d4rkwyng/inspectron-sao-dc34/THIRD_PARTY_LICENSES.md

# Third-party code notices

## Adafruit_CircuitPython_ST7789

Redistributed in compiled form at `firmware/dist/lib/adafruit_st7789.mpy`
(and inside the released golden image).
https://github.com/adafruit/Adafruit_CircuitPython_ST7789

> MIT License
>
> Copyright (c) 2019 Melissa LeBlanc-Williams for Adafruit Industries
>
> Permission is hereby granted, free of charge, to any person obtaining a
> copy of this software and associated documentation files (the
> "Software"), to deal in the Software without restriction, including
> without limitation the rights to use, copy, modify, merge, publish,
> distribute, sublicense, and/or sell copies of the Software, and to
> permit persons to whom the Software is furnished to do so, subject to
> the following conditions:
>
> The above copyright notice and this permission notice shall be included
> in all copies or substantial portions of the Software.
>
> THE SOFTWARE IS PROVIDED "AS IS", WITHOUT WARRANTY OF ANY KIND, EXPRESS
> OR IMPLIED, INCLUDING BUT NOT LIMITED TO THE WARRANTIES OF
> MERCHANTABILITY, FITNESS FOR A PARTICULAR PURPOSE AND NONINFRINGEMENT.
> IN NO EVENT SHALL THE AUTHORS OR COPYRIGHT HOLDERS BE LIABLE FOR ANY
> CLAIM, DAMAGES OR OTHER LIABILITY, WHETHER IN AN ACTION OF CONTRACT,
> TORT OR OTHERWISE, ARISING FROM, OUT OF OR IN CONNECTION WITH THE
> SOFTWARE OR THE USE OR OTHER DEALINGS IN THE SOFTWARE.

## CircuitPython

The released golden image contains the CircuitPython 10.2.1 firmware
build. https://circuitpython.org

> MIT License
>
> Copyright (c) 2013-2026 Damien P. George and contributors;
> Copyright (c) Adafruit Industries and CircuitPython contributors
>
> (Same MIT permission and warranty text as above; full license at
> https://github.com/adafruit/circuitpython/blob/main/LICENSE)

## picotool

Referenced by the factory tooling, not redistributed. BSD-3-Clause,
© Raspberry Pi (Trading) Ltd.
https://github.com/raspberrypi/picotool
