d4rkwyng/inspectron-sao-dc34/sitegen/CHANNELS.md

# CHANNEL ROSTER — GENERATED by gen_secrets.py, do not hand-edit.
# Contains ALL ANSWERS. sitegen/ only — never deploy, never copy to
# the device. Regenerate: python3 sitegen/gen_secrets.py

## Visible dial (38 channels — TV/movies/commercials/music video only)

| CH | file | shown as | size |
|---|---|---|---|
| 2 | memes/stand_by.gif | STAND BY | 139KB |
| 3 | memes/wargames.gif | WARGAMES | 259KB |
| 4 | memes/matrix.gif | THE MATRIX | 319KB |
| 5 | memes/homerbush.gif | HOMER BUSH | 290KB |
| 6 | memes/apple1984.gif | MAC 1984 | 199KB |
| 7 | memes/colorbars.gif | COLOR BARS | 130KB |
| 8 | memes/ncis.gif | NCIS | 256KB |
| 10 | memes/readingrainbow.gif | RAINBOW | 194KB |
| 13 | memes/hacktheplanet.gif | HACK PLANET | 296KB |
| 15 | memes/nedry.gif | NEDRY | 186KB |
| 16 | memes/itcrowd_fire.gif | IT CROWD | 300KB |
| 17 | memes/printer.gif | PC LOAD LTR | 269KB |
| 19 | memes/eas.gif | EAS TEST | 53KB |
| 20 | memes/mtv.gif | MTV | 125KB |
| 21 | memes/beavis.gif | BEAVIS | 45KB |
| 22 | memes/fsociety.gif | FSOCIETY | 415KB |
| 25 | memes/alf.gif | ALF | 201KB |
| 26 | memes/smurfs.gif | SMURFS | 236KB |
| 27 | memes/scooby.gif | SCOOBY DOO | 154KB |
| 29 | memes/ducktales.gif | DUCKTALES | 217KB |
| 30 | memes/tmnt.gif | TURTLES | 137KB |
| 31 | memes/heman.gif | HE-MAN | 155KB |
| 32 | memes/transformers.gif | AUTOBOTS | 100KB |
| 33 | memes/dinosaurs.gif | DINOSAURS | 182KB |
| 34 | memes/defcon34.gif | DEF CON 34 | 67KB |
| 38 | memes/shamwow.gif | SHAMWOW | 174KB |
| 39 | memes/slimjim.gif | SLIM JIM | 194KB |
| 40 | memes/wheresthebeef.gif | WHERES BEEF | 174KB |
| 41 | memes/koolaid.gif | KOOL-AID | 227KB |
| 48 | memes/erasebutton.gif | RED BUTTON | 154KB |
| 49 | memes/grant.gif | DR GRANT | 243KB |
| 50 | memes/peterknee.gif | PETER KNEE | 234KB |
| 51 | memes/area51.gif | AREA 51 | 229KB |
| 52 | memes/dvd.gif | DVD LOGO | 382KB |
| 54 | memes/vegasstrip.gif | THE STRIP | 402KB |
| 56 | memes/riviera.gif | RIVIERA | 408KB |
| 57 | memes/fearloathing.gif | BAT COUNTRY | 281KB |
| 61 | memes/hackerman.gif | HACKERMAN | 211KB |

## Dead air (knock seats; prune when their reward unlocks)

CH 11, CH 23, CH 42, CH 66, CH 88

## Hidden — dial to unlock (18)

| dial | file | note | size |
|---|---|---|---|
| 011.0 | /secret/maxheadroom.gif | CF-05 Signal Intrusion | 141KB |
| 023.0 | /secret/testcardf.gif | CF-06 Test Card Lineage (knock) | 592KB |
| 034.1 | /secret/ident.gif | CF-00 Sign-On | 88KB |
| 053.0 | /secret/dns.gif | insider | 263KB |
| 066.0 | /secret/apollo.gif | CF-07 Tranquility Descent (knock) | 421KB |
| 080.0 | /secret/gadget.gif | CF-02 Know Your Set | 117KB |
| 088.0 | /secret/keyboardcat.gif | insider | 258KB |
| 089.0 | /secret/toasters.gif | insider | 271KB |
| 097.0 | /secret/clippy.gif | insider | 177KB |
| 098.0 | /secret/bsod.gif | insider | 106KB |
| 123.0 | /secret/elmothunder.gif | insider | 137KB |
| 170.4 | /secret/wopr.gif | CF-04 Only Winning Move | 10KB |
| 199.3 | /secret/defcon1.gif | CF-01 First Transmission | 523KB |
| 210.1 | /secret/allyourbase.gif | insider | 570KB |
| 222.0 | /secret/nyan.gif | insider | 81KB |
| 400.4 | /secret/silicon.gif | CF-03 Count the Frames | 297KB |
| 404.0 | /secret/meeseeks.gif | CF-09 Master Control (meta) | 260KB |
| 911.0 | /secret/this_is_fine.gif | insider | 173KB |

## Station knocks

- 003.0 -> 006.0 -> 023.0
- 063.0 -> 064.0 -> 066.0

## Other unlocks

- Konami (up up down down up down MODE) -> /secret/mooncake.gif (274KB)
- Badge I2C first contact -> /secret/badgelink.gif (19KB)

## Traps (play once, never persist)

| dial | file |
|---|---|
| 000.0 | /secret/rickroll.gif |
| 007.0 | /secret/rickroll.gif |
| 009.0 | /secret/movedon.gif |
| 013.3 | /secret/dickbutt.gif |
| 042.0 | /secret/dontpanic.gif |
| 067.0 | /secret/nogod67.gif |
| 069.0 | /secret/rickroll.gif |
| 088.8 | /secret/rickroll.gif |
| 123.4 | /secret/rickroll.gif |
| 133.7 | /secret/rickroll.gif |
| 187.0 | /secret/spyvsspy.gif |
| 345.0 | /secret/paperwork.gif |
| 420.0 | /secret/weed420.gif |
| 666.0 | /secret/rickroll.gif |
| 777.0 | /secret/jackpot777.gif |
