d4rkwyng/inspectron-sao-dc34/design/render-back.png

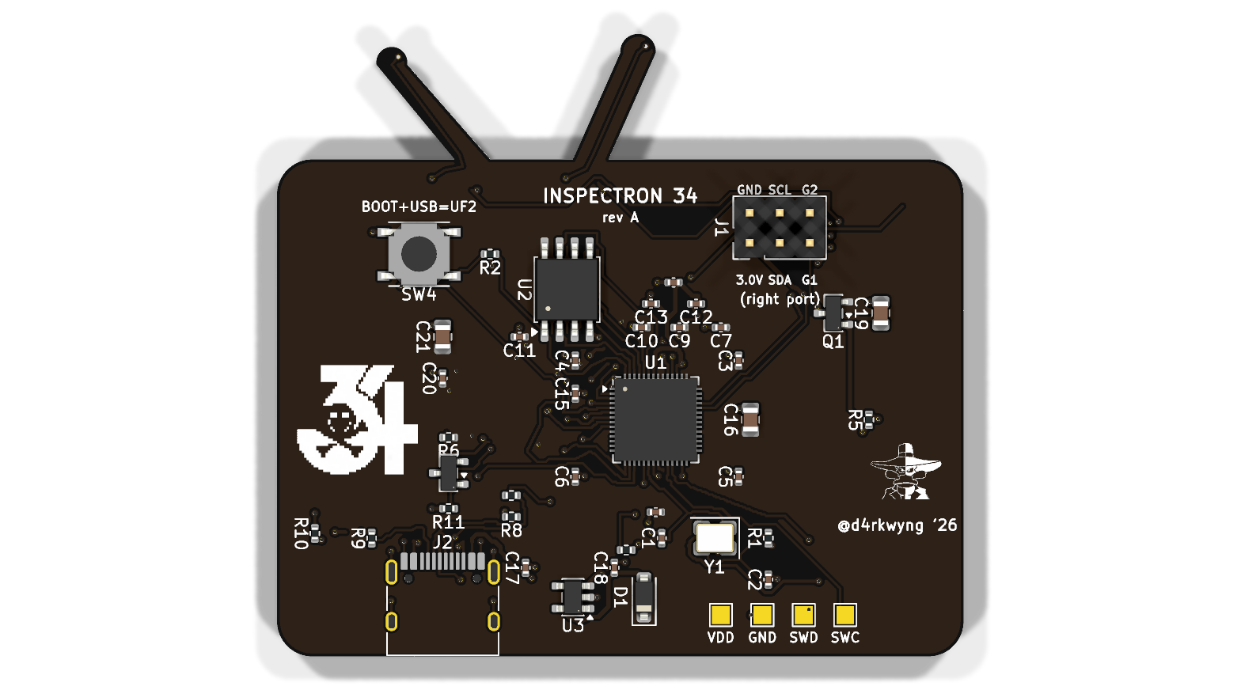
design/render-back.png
