d4rkwyng/inspectron-sao-dc34/design/render-front.png

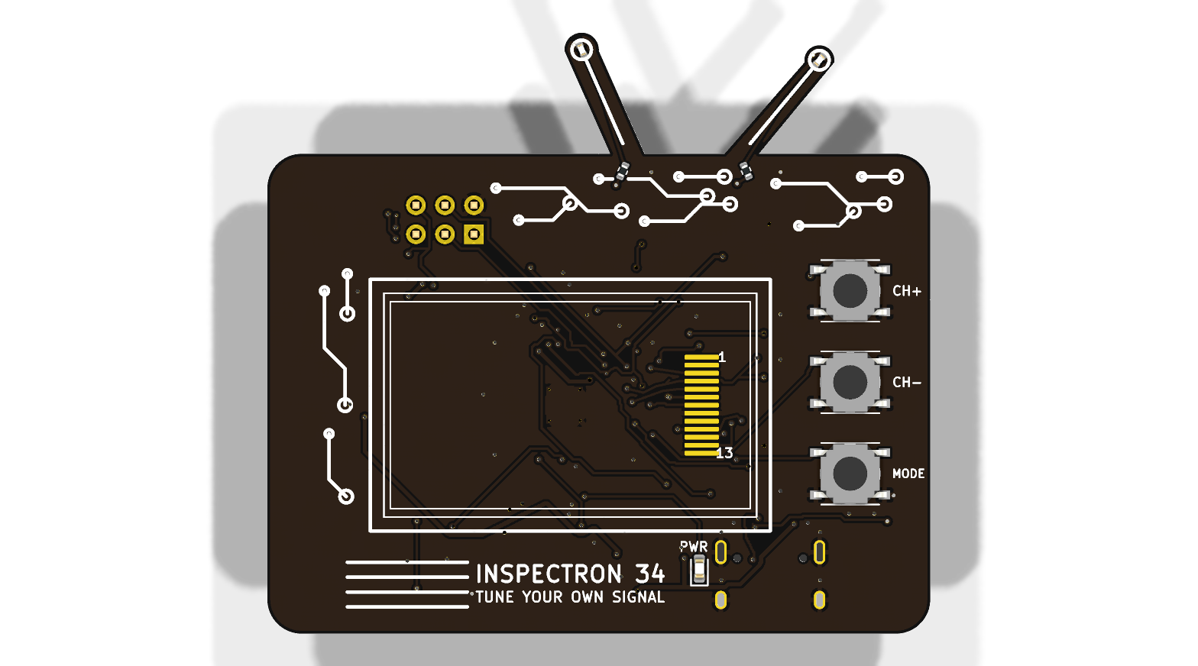
design/render-front.png
