d4rkwyng/inspectron-sao-dc34/firmware/memes/static.gif

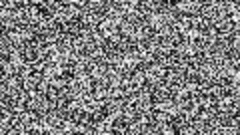
firmware/memes/static.gif
