d4rkwyng/inspectron-sao-dc34/memes/alf.gif

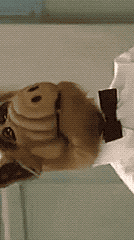
memes/alf.gif
