d4rkwyng/inspectron-sao-dc34/memes/apple1984.gif

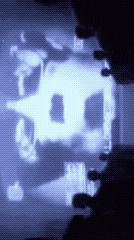
memes/apple1984.gif
