d4rkwyng/inspectron-sao-dc34/memes/area51.gif

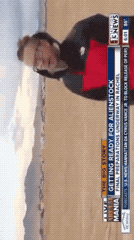
memes/area51.gif
