d4rkwyng/inspectron-sao-dc34/memes/beavis.gif

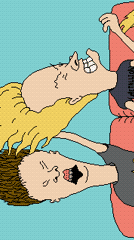
memes/beavis.gif
