d4rkwyng/inspectron-sao-dc34/memes/colorbars.gif

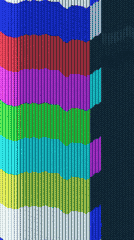
memes/colorbars.gif
