d4rkwyng/inspectron-sao-dc34/memes/defcon34.gif

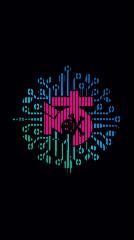
memes/defcon34.gif
