d4rkwyng/inspectron-sao-dc34/memes/dinosaurs.gif

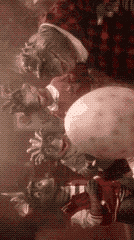
memes/dinosaurs.gif
