d4rkwyng/inspectron-sao-dc34/memes/ducktales.gif

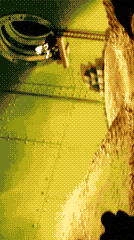
memes/ducktales.gif
