d4rkwyng/inspectron-sao-dc34/memes/dvd.gif

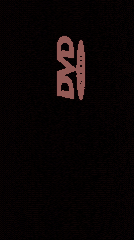
memes/dvd.gif
