d4rkwyng/inspectron-sao-dc34/memes/eas.gif

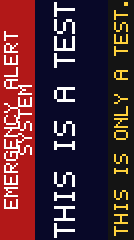
memes/eas.gif
