d4rkwyng/inspectron-sao-dc34/memes/erasebutton.gif

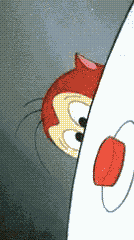
memes/erasebutton.gif
