d4rkwyng/inspectron-sao-dc34/memes/fearloathing.gif

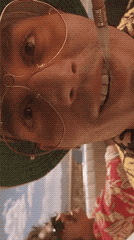
memes/fearloathing.gif
