d4rkwyng/inspectron-sao-dc34/memes/fsociety.gif

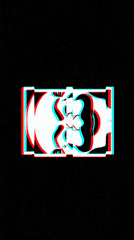
memes/fsociety.gif
