d4rkwyng/inspectron-sao-dc34/memes/grant.gif

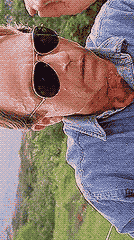
memes/grant.gif
