d4rkwyng/inspectron-sao-dc34/memes/hackerman.gif

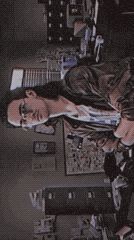
memes/hackerman.gif
