d4rkwyng/inspectron-sao-dc34/memes/hacktheplanet.gif

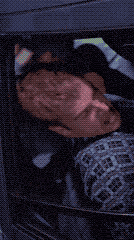
memes/hacktheplanet.gif
