d4rkwyng/inspectron-sao-dc34/memes/heman.gif

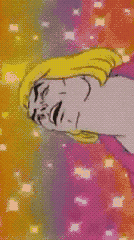
memes/heman.gif
