d4rkwyng/inspectron-sao-dc34/memes/homerbush.gif

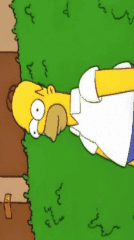
memes/homerbush.gif
