d4rkwyng/inspectron-sao-dc34/memes/itcrowd_fire.gif

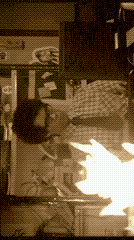
memes/itcrowd_fire.gif
