d4rkwyng/inspectron-sao-dc34/memes/koolaid.gif

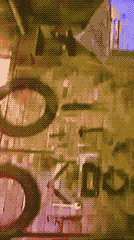
memes/koolaid.gif
