d4rkwyng/inspectron-sao-dc34/memes/matrix.gif

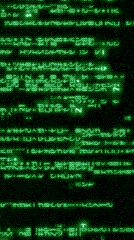
memes/matrix.gif
