d4rkwyng/inspectron-sao-dc34/memes/mtv.gif

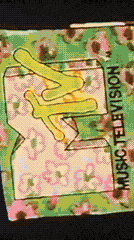
memes/mtv.gif
