d4rkwyng/inspectron-sao-dc34/memes/ncis.gif

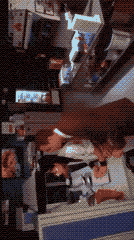
memes/ncis.gif
