d4rkwyng/inspectron-sao-dc34/memes/nedry.gif

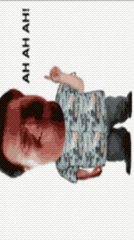
memes/nedry.gif
