d4rkwyng/inspectron-sao-dc34/memes/peterknee.gif

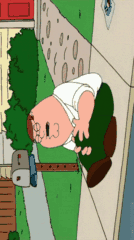
memes/peterknee.gif
