d4rkwyng/inspectron-sao-dc34/memes/readingrainbow.gif

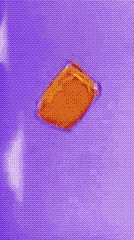
memes/readingrainbow.gif
