d4rkwyng/inspectron-sao-dc34/memes/riviera.gif

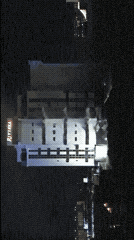
memes/riviera.gif
