d4rkwyng/inspectron-sao-dc34/memes/scooby.gif

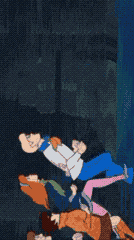
memes/scooby.gif
