d4rkwyng/inspectron-sao-dc34/memes/shamwow.gif

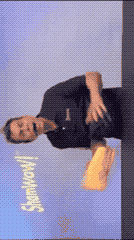
memes/shamwow.gif
