d4rkwyng/inspectron-sao-dc34/memes/slimjim.gif

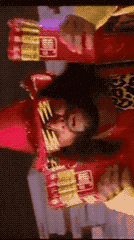
memes/slimjim.gif
