d4rkwyng/inspectron-sao-dc34/memes/smurfs.gif

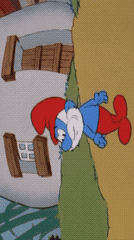
memes/smurfs.gif
