d4rkwyng/inspectron-sao-dc34/memes/stand_by.gif

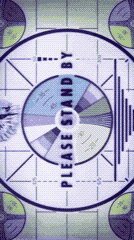
memes/stand_by.gif
