d4rkwyng/inspectron-sao-dc34/memes/tmnt.gif

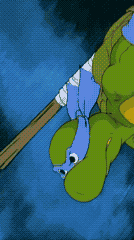
memes/tmnt.gif
