d4rkwyng/inspectron-sao-dc34/memes/transformers.gif

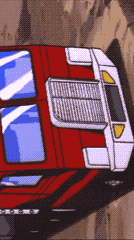
memes/transformers.gif
