d4rkwyng/inspectron-sao-dc34/memes/vegasstrip.gif

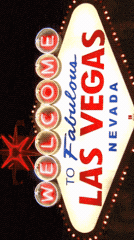
memes/vegasstrip.gif
