d4rkwyng/inspectron-sao-dc34/memes/wargames.gif

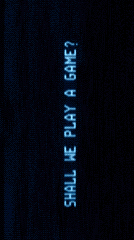
memes/wargames.gif
