d4rkwyng/inspectron-sao-dc34/memes/wheresthebeef.gif

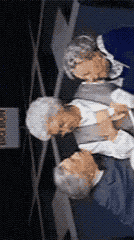
memes/wheresthebeef.gif
