d4rkwyng/inspectron-sao-dc34/secret/allyourbase.gif

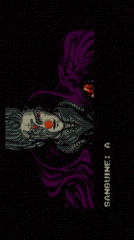
secret/allyourbase.gif
