d4rkwyng/inspectron-sao-dc34/secret/apollo.gif

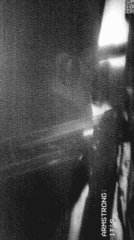
secret/apollo.gif
