d4rkwyng/inspectron-sao-dc34/secret/bsod.gif

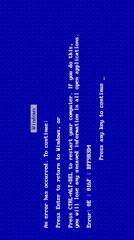
secret/bsod.gif
