d4rkwyng/inspectron-sao-dc34/secret/clippy.gif

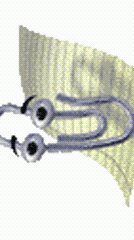
secret/clippy.gif
