d4rkwyng/inspectron-sao-dc34/secret/defcon1.gif

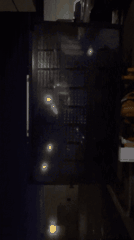
secret/defcon1.gif
