d4rkwyng/inspectron-sao-dc34/secret/dickbutt.gif

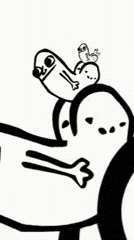
secret/dickbutt.gif
