d4rkwyng/inspectron-sao-dc34/secret/dns.gif

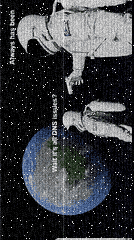
secret/dns.gif
