d4rkwyng/inspectron-sao-dc34/secret/dontpanic.gif

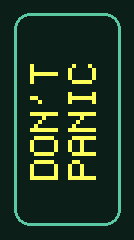
secret/dontpanic.gif
