d4rkwyng/inspectron-sao-dc34/secret/elmothunder.gif

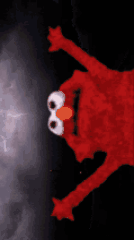
secret/elmothunder.gif
