d4rkwyng/inspectron-sao-dc34/secret/gadget.gif

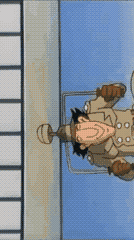
secret/gadget.gif
