d4rkwyng/inspectron-sao-dc34/secret/ident.gif

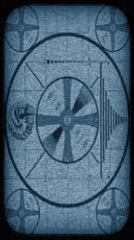
secret/ident.gif
