d4rkwyng/inspectron-sao-dc34/secret/jackpot777.gif

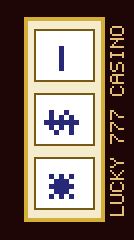
secret/jackpot777.gif
