d4rkwyng/inspectron-sao-dc34/secret/keyboardcat.gif

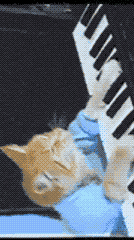
secret/keyboardcat.gif
