d4rkwyng/inspectron-sao-dc34/secret/maxheadroom.gif

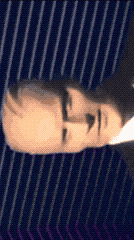
secret/maxheadroom.gif
