d4rkwyng/inspectron-sao-dc34/secret/meeseeks.gif

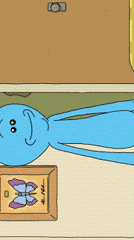
secret/meeseeks.gif
