d4rkwyng/inspectron-sao-dc34/secret/mooncake.gif

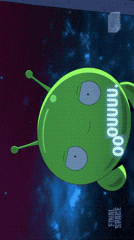
secret/mooncake.gif
