d4rkwyng/inspectron-sao-dc34/secret/movedon.gif

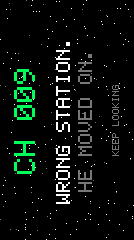
secret/movedon.gif
