d4rkwyng/inspectron-sao-dc34/secret/nogod67.gif

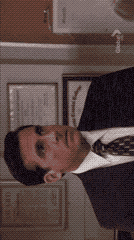
secret/nogod67.gif
