d4rkwyng/inspectron-sao-dc34/secret/nyan.gif

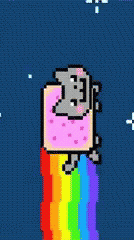
secret/nyan.gif
