d4rkwyng/inspectron-sao-dc34/secret/paperwork.gif

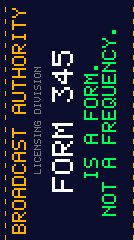
secret/paperwork.gif
