d4rkwyng/inspectron-sao-dc34/secret/rickroll.gif

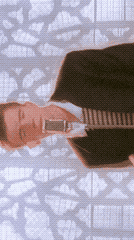
secret/rickroll.gif
