d4rkwyng/inspectron-sao-dc34/secret/spyvsspy.gif

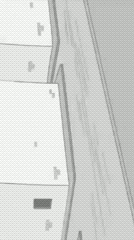
secret/spyvsspy.gif
