d4rkwyng/inspectron-sao-dc34/secret/this_is_fine.gif

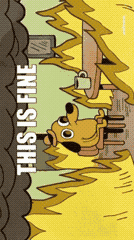
secret/this_is_fine.gif
