d4rkwyng/inspectron-sao-dc34/secret/toasters.gif

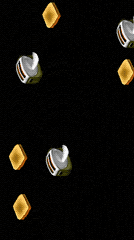
secret/toasters.gif
