d4rkwyng/inspectron-sao-dc34/secret/weed420.gif

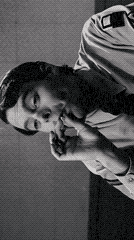
secret/weed420.gif
