d4rkwyng/inspectron-sao-dc34/secret/wopr.gif

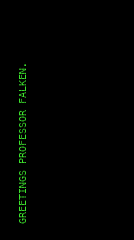
secret/wopr.gif
