d4rkwyng/inspectron-sao-dc34/sim/memes/channel1.gif

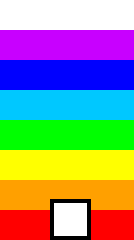
sim/memes/channel1.gif
