d4rkwyng/inspectron-sao-dc34/sim/secret/agency.gif

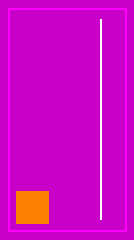
sim/secret/agency.gif
