d4rkwyng/inspectron-sao-dc34/site/assets/dsky.png

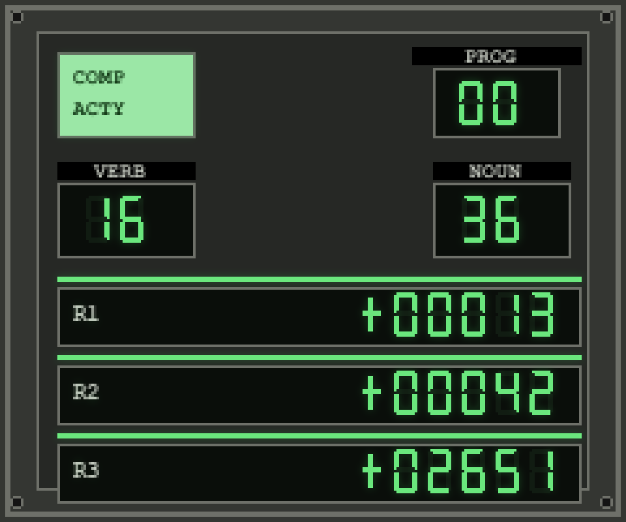
site/assets/dsky.png
