d4rkwyng/inspectron-sao-dc34/site/assets/form-345.png

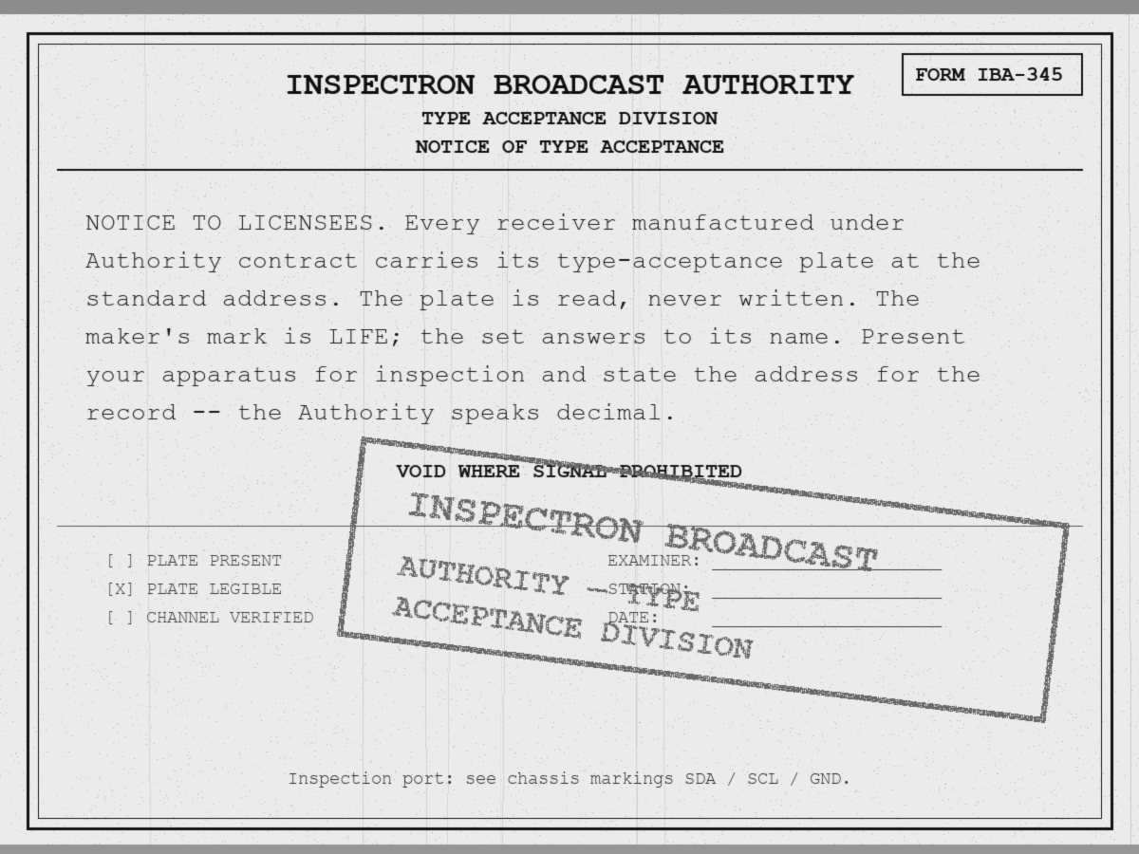
site/assets/form-345.png
