d4rkwyng/inspectron-sao-dc34/site/assets/ident-card.png

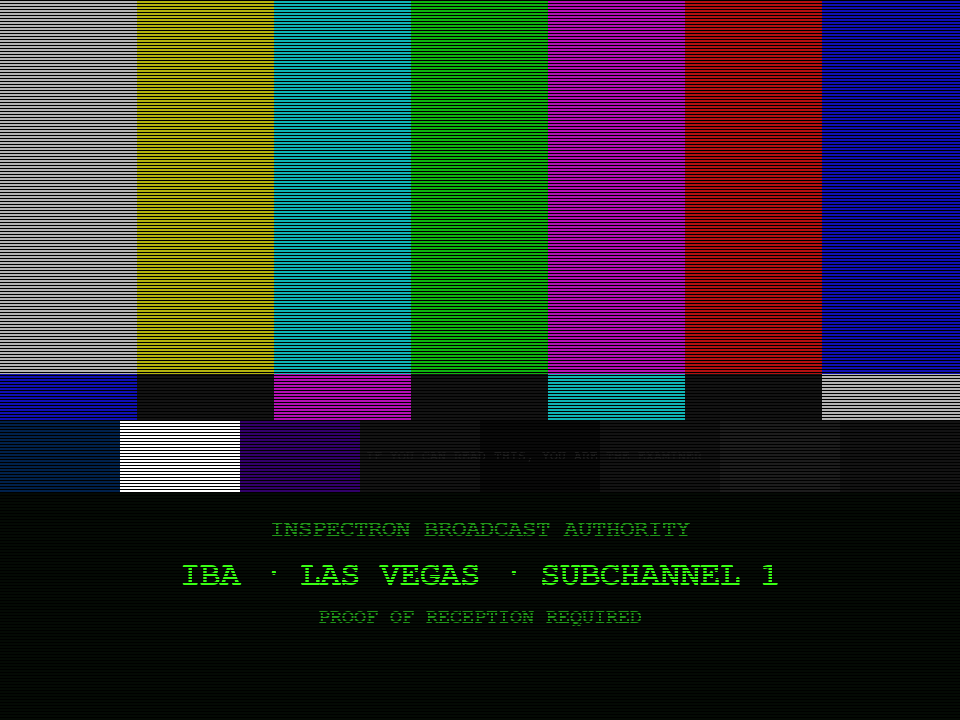
site/assets/ident-card.png
