d4rkwyng/inspectron-sao-dc34/site/assets/intrusion-still.png

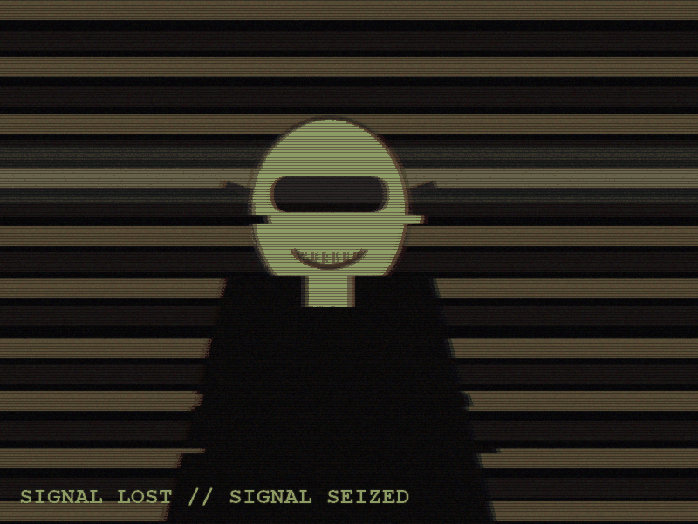
site/assets/intrusion-still.png
