d4rkwyng/inspectron-sao-dc34/site/assets/lineage.png

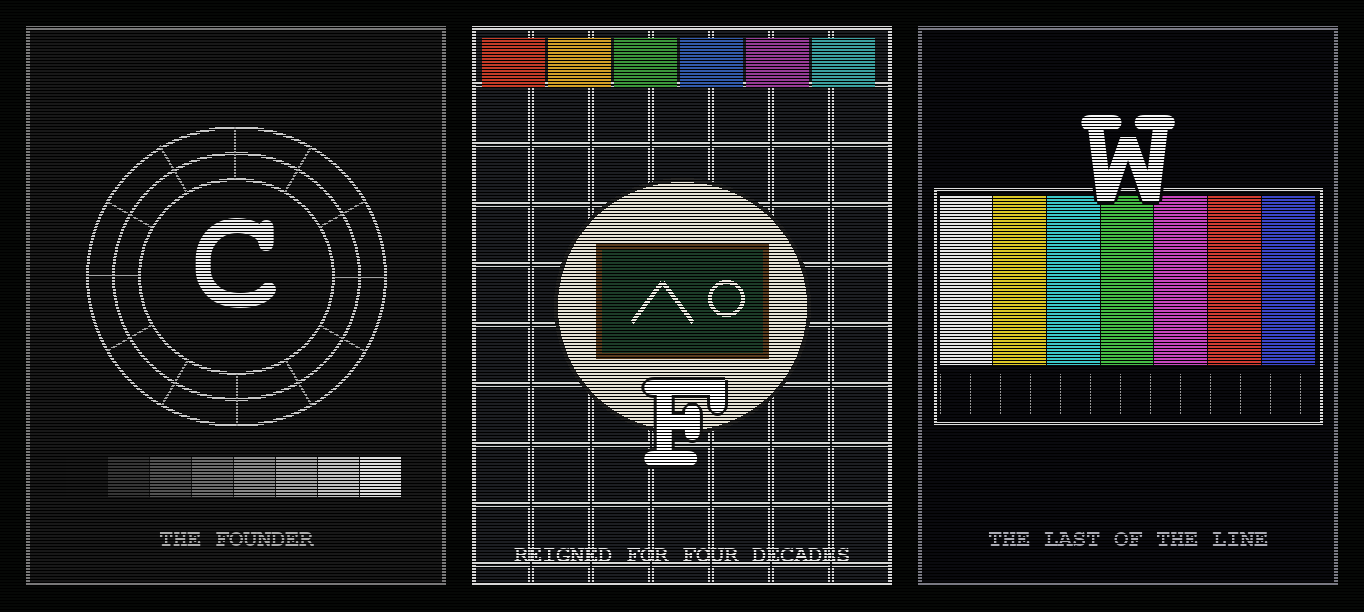
site/assets/lineage.png
