d4rkwyng/inspectron-sao-dc34/site/assets/mcp-reel.gif

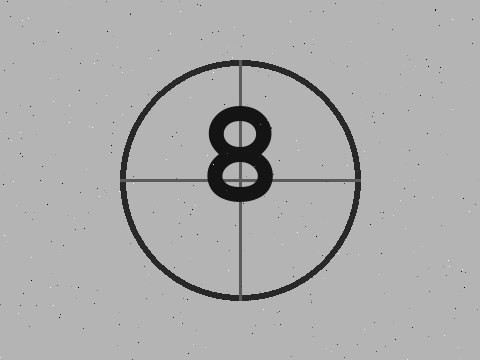
site/assets/mcp-reel.gif
