d4rkwyng/inspectron-sao-dc34/site/assets/seal.png

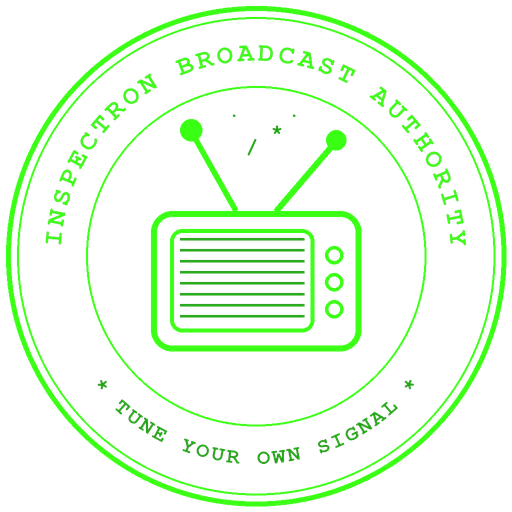
site/assets/seal.png
