d4rkwyng/inspectron-sao-dc34/design/render-assembled.png

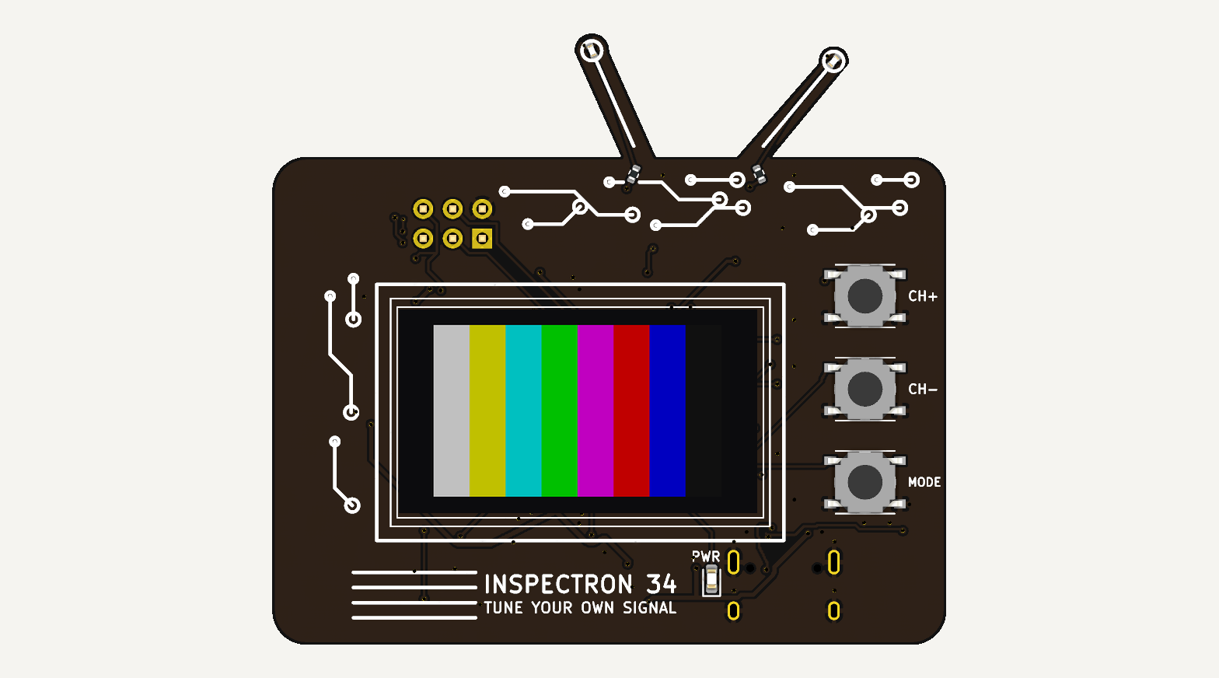
design/render-assembled.png
