d4rkwyng/inspectron-sao-dc34/memes/printer.gif

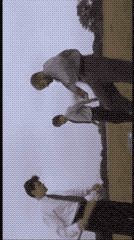
memes/printer.gif
