d4rkwyng/inspectron-sao-dc34/firmware/memes/testcard.gif

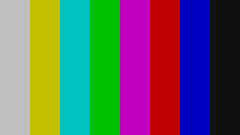
firmware/memes/testcard.gif
