d4rkwyng/inspectron-sao-dc34/secret/testcardf.gif

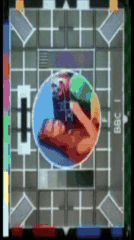
secret/testcardf.gif
