d4rkwyng/inspectron-sao-dc34/site/assets/testpattern-001.png

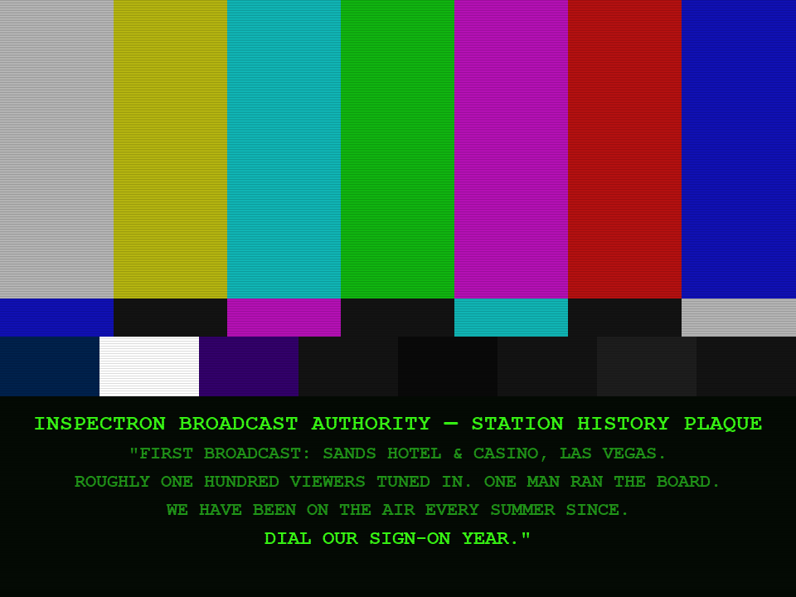
site/assets/testpattern-001.png
