d4rkwyng/inspectron-sao-dc34/hardware/dc34-sao-schematic.pdf

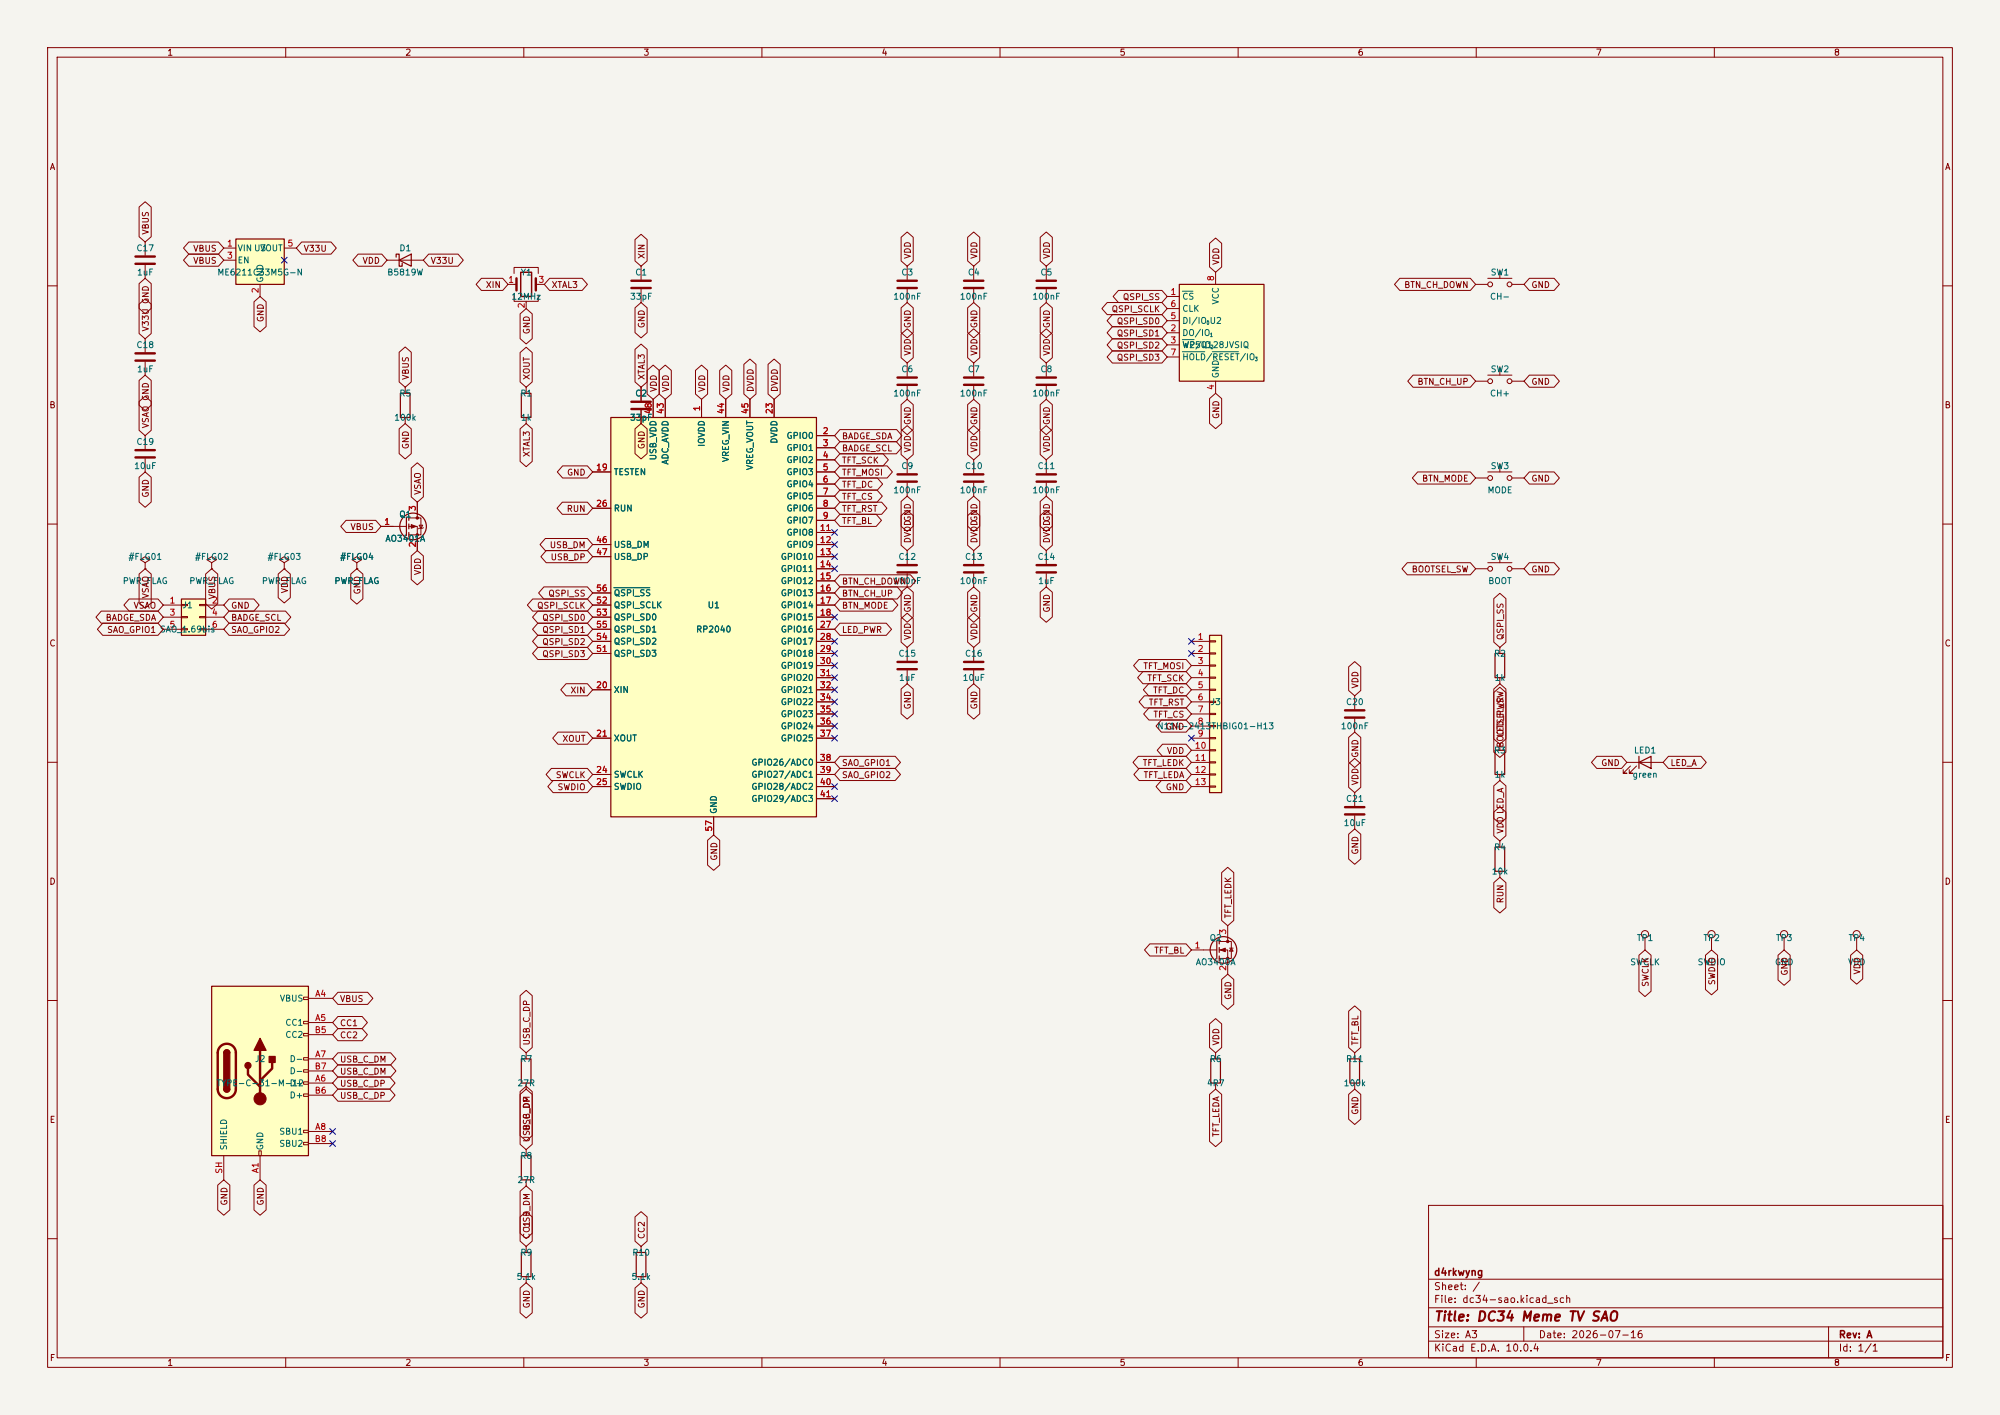
[picture p87: page 1]

VBUS VBUS GND V33U GND VSAO

Size: A3 | Rev: A
KiCad E.D.A. 10.0.4 | Id: 1/1
