d4rkwyng/inspectron-sao-dc34/(list of files, drawings)

Other design files:
hardware/dc34-sao-chord.dsn
hardware/dc34-sao.dsn
