d4rkwyng/inspectron-sao-dc34/hardware/dc34-sao.kicad_pcb

## KiCad design hardware/dc34-sao.kicad_pcb (2026-08-11)

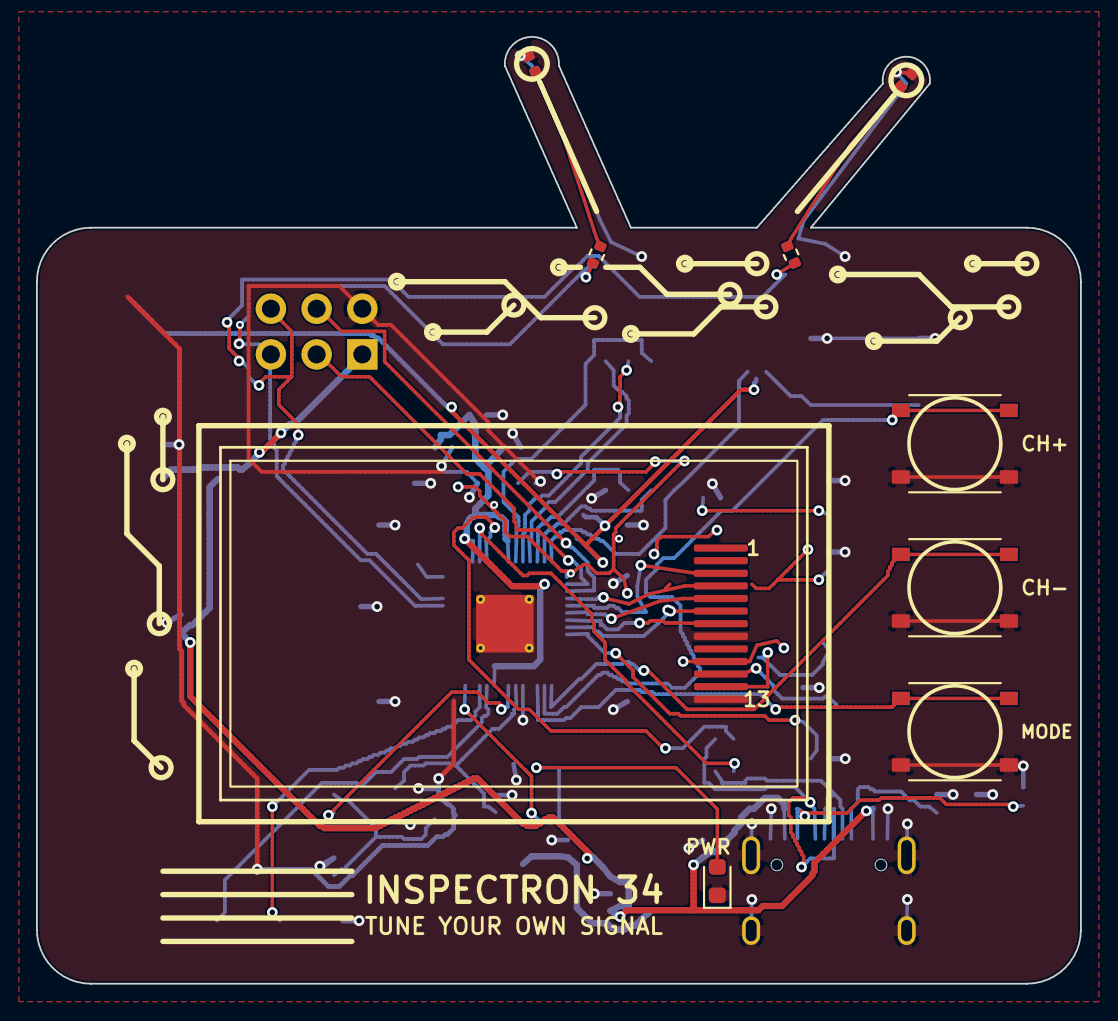
[picture p88: board dc34-sao.kicad_pcb from above]

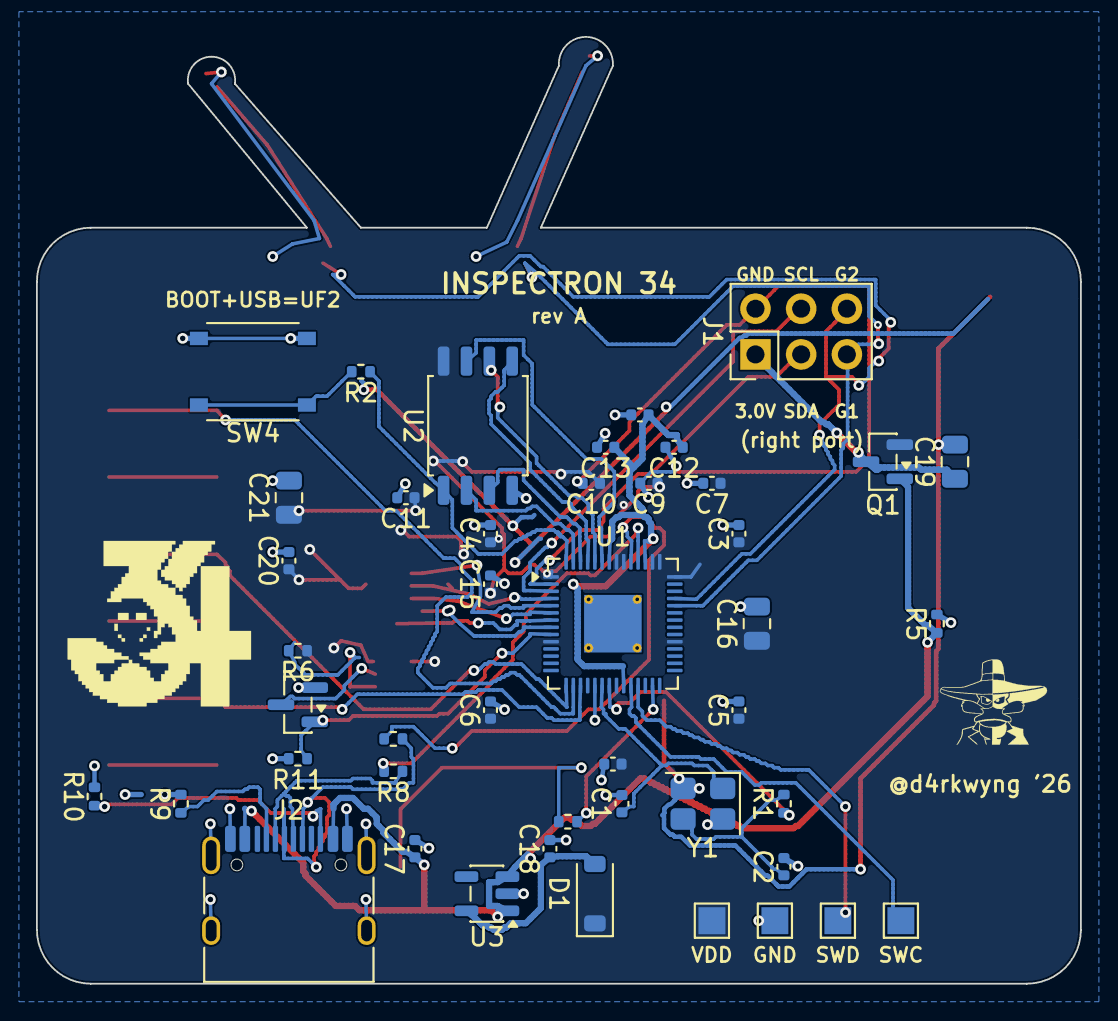
[picture p89: board dc34-sao.kicad_pcb from below]

Board: 2 copper layers, 58.0 x 52.6 mm, 56 parts (47 on the bottom side), 43 nets.

Parts:
C1, C2, C3, C4, C5, C6, C7, C8, C9, C10, C11, C12, C13, C14, C15, C17, C18, C20: C_0402_1005Metric
C16, C19, C21: C_0805_2012Metric
D1: D_SOD-123
G1: LOGO; d4rkwyng
G2: 34m; dc34_34skull_mid
J1: PinHeader_2x03_P2.54mm_Vertical
J2: USB_C_Receptacle_HRO_TYPE-C-31-M-12
J3: TFT_FPC_13P_N114
LED1: LED_0603_1608Metric
LED2, LED3: red; LED_0402_1005Metric
Q1, Q2: SOT-23
R1, R2, R3, R5, R6, R7, R8, R9, R10, R11: R_0402_1005Metric
R12, R13: 470R; R_0402_1005Metric
SW1, SW2, SW3, SW4: SW_TS-1187A
TP1, TP2, TP3, TP4: TestPoint_Pad_1.5x1.5mm
U1: QFN-56-1EP_7x7mm_P0.4mm_EP3.2x3.2mm_ThermalVias
U2: SOIC-8_5.3x5.3mm_P1.27mm
U3: SOT-23-5
Y1: Crystal_SMD_3225-4Pin_3.2x2.5mm

Connections:
ANT_L: LED2.2, R12.2
ANT_R: LED3.2, R13.2
BADGE_SCL: J1.4, U1.3
BADGE_SDA: J1.3, U1.2
BOOTSEL_SW: R2.2, SW4.1
BTN_CH_DOWN: SW1.1, U1.15
BTN_CH_UP: SW2.1, U1.16
BTN_MODE: SW3.1, U1.17
CC1: J2.A5, R9.1
CC2: J2.B5, R10.1
DVDD: C12.1, C13.1, C14.1, U1.23, U1.45, U1.50
GND: C1.2, C2.2, C3.2, C4.2, C5.2, C6.2, C7.2, C8.2, C9.2, C10.2, C11.2, C12.2, C13.2, C14.2, C15.2, C16.2, C17.2, C18.2, C19.2, C20.2, C21.2, J1.2, J2.A1, J2.A12, J2.B1, J2.B12, J2.SH, J3.8, J3.13, LED1.1, LED2.1, LED3.1, Q2.2, R5.2, R9.2, R10.2, R11.2, SW1.2, SW2.2, SW3.2, SW4.2, TP3.1, U1.19, U1.57, U2.4, U3.2, Y1.2, Y1.4
LED_A: LED1.2, R3.2
LED_PWR: R3.1, U1.27
QSPI_SCLK: U1.52, U2.6
QSPI_SD0: U1.53, U2.5
QSPI_SD1: U1.55, U2.2
QSPI_SD2: U1.54, U2.3
QSPI_SD3: U1.51, U2.7
QSPI_SS: R2.1, U1.56, U2.1
SAO_GPIO1: J1.5, R12.1, U1.38
SAO_GPIO2: J1.6, R13.1, U1.39
SWCLK: TP1.1, U1.24
SWDIO: TP2.1, U1.25
TFT_BL: Q2.1, R11.1, U1.9
TFT_CS: J3.7, U1.7
TFT_DC: J3.5, U1.6
TFT_LEDA: J3.12, R6.2
TFT_LEDK: J3.11, Q2.3
TFT_MOSI: J3.3, U1.5
TFT_RST: J3.6, U1.8
TFT_SCK: J3.4, U1.4
USB_C_DM: J2.A7, J2.B7, R8.1
USB_C_DP: J2.A6, J2.B6, R7.1
USB_DM: R8.2, U1.46
USB_DP: R7.2, U1.47
V33U: C18.1, D1.2, U3.5
VBUS: C17.1, J2.A4, J2.A9, J2.B4, J2.B9, Q1.1, R5.1, U3.1, U3.3
VDD: C3.1, C4.1, C5.1, C6.1, C7.1, C8.1, C9.1, C10.1, C11.1, C15.1, C16.1, C20.1, C21.1, D1.1, J3.10, Q1.2, R6.1, TP4.1, U1.1, U1.10, U1.22, U1.33, U1.42, U1.43, U1.44, U1.48, U1.49, U2.8
VSAO: C19.1, J1.1, Q1.3
XIN: C1.1, U1.20, Y1.1
XOUT: R1.1, U1.21
XTAL3: C2.1, R1.2, Y1.3
