d4rkwyng/inspectron-sao-dc34/(commit log)

2026-08-11 INSPECTRON 34 — public release
    DEF CON 34 CRT-TV SAO: RP2040 + CircuitPython meme-GIF television with a
    hidden puzzle game. Hardware (KiCad 10 + a custom maze router), firmware
    V5 (direct-render engine, MASTER CONTROL menu, frequency-tuner unlock
    game, themes, host-badge I2C control), desktop simulator, puzzle-site
    generator, and the factory flashing line. ~30-board run for DC34; the
    con is over, so everything ships — answers included, see the README
    spoiler warning.
    TUNE YOUR OWN SIGNAL.
    [dc34-sao-chord.dsn, dc34-sao-revA-BOM-jlcpcb.csv, dc34-sao-revA-BOM.csv, dc34-sao-revA-positions.csv, dc34-sao.dsn, dc34-sao.kicad_pcb, dc34-sao.kicad_sch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]
2026-08-12 golden v5: captured from a blessed board — restore is one step again
    Byte-verified with picotool after capture; board updated to the blessed
    V5 set (byte-verified), on-glass checked, factory-reset to day-one state
    first. FLASHING + flash scripts now point at golden-inspectron34-v5;
    verify-board derives pack counts from the repo instead of hardcoding
    them (secret/ is 29 since innout was dropped).
2026-09-11 sim/stubs/gifio: remove dead _rgb888_to_rgb565_swapped helper
    Unused since OnDiskGif.__init__ does the same RGB888->RGB565-swapped
    conversion inline with numpy for vectorized speed. Excluded from
    ruff.toml's scope (sim/stubs is deliberately unlinted as desktop-only
    shim code), which is why it slipped past the quality gate.
    [gifio.py]
2026-10-05 sim: fix broken quality-gate repro — numpy 2.0.2 has no wheel, pygame breaks on 3.14
    sim/.venv rebuilt from scratch no longer reproduces: numpy==2.0.2 has no
    prebuilt wheel for current Python/macOS toolchains and its sdist fails to
    compile against current clang (std::ptrdiff_t / CheckedIndexer errors in
    numpy's string ufunc code) -- bumped to 2.2.6, which has wheels for cp313
    and cp314 arm64 and uses only stable numpy 2.x APIs (reshape/astype/
    frombuffer/dstack/ascontiguousarray) already in use across sim/stubs/.
    Separately, confirmed by direct reproduction that pygame 2.6.1 (still the
    latest release on PyPI) has a real upstream circular-import bug under
    Python 3.14: pygame/font.py import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
2026-10-14 provisioning: copy the two theme splash variants, not just splash.gif
    factory-flash.sh, provision-board.sh and FLASHING's build-from-source
    recipe only copied firmware/splash.gif. code.py picks /splash-dc34.gif or
    /splash-inv.gif from the THEME setting and silently falls back to the
    default splash when the file is absent, so boards provisioned from source
    never showed the themed splash. FLASHING path 2 and the golden image
    already include them (~64KB each).
    Verified: bash -n on both scripts; quality gate passes. Not run against
    hardware.
2026-10-17 docs/test/tooling: fix GPIO + sim drift, add NVM/knock contract tests
    - INTERFACING.md / pins.md / ENGINEERING.md: since V4 the firmware drives
    GP26/27 (SAO GPIO1/2) as PWM outputs at all times; the docs still told
    badge authors to drive those lines to light the antennas, which now
    contends with a push-pull output. Point them at 0xF5 instead. Also
    correct the 0xF3/0xF5-in-standby claim (held until wake, not live) and
    the 0xF0-0xF4 register range (0xF5 exists).
    - sim/README.md, sim/run.py: key table described MODE-hold as standby and
    the combo as the tuner (both now open MASTER CONTROL), listed three
    frequencies that unlock nothing, described a selftest script that no
    longer e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
2026-10-17 firmware: dispatch events returned mid-EAS / mid-trap instead of dropping
    The EAS interrupt and trap players only handled up/down (and mode in the
    trap loop); every other event play_gif returned was discarded. Concrete
    losses: a konami sequence whose final press landed during an EAS strike
    (reproduced in the sim: unlock lost on main, granted with this fix), a
    MODE-hold menu request during a trap, the standby idle timeout while a
    trap plays (it reset the idle clock, so a parked trap stayed lit a
    second full standby period), and the first-contact "badge" event during
    an alert (no banner, BADGE LINK missing from the lineup until the next
    rescan). Those events now go to a one-shot `pending` slot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
2026-10-28 docs: regenerate stale CHANNELS.md, note splash GIFs in manual install
    sitegen/CHANNELS.md was last generated before ch34 (DEF CON 34) moved from
    dead air onto the visible dial and before several /secret rewards were
    re-encoded; it listed 37 channels and sizes like testcardf.gif at 2KB
    (actual 592KB). Content is now byte-identical to gen_secrets.py output;
    firmware/secrets_config.py regenerates unchanged.
    firmware/README.md manual install omitted the three root splash GIFs.
    Neither deploy_production.py nor rigdeploy.py copies them; FLASHING.md and
    test/provision-board.sh already do.
2026-10-28 hardware: guard gen_pcb.py against the hand-edited board; fix DRC gate text
    ENGINEERING.md says never re-run gen_pcb.py against dc34-sao.kicad_pcb,
    but nothing enforced it, and post_route.sh still calls gen_pcb.py --final,
    which loads the finished board and adds a second GND/VDD zone pair plus
    stitch vias. Default and --dump modes rebuild the board from scratch.
    gen_pcb.py now exits 1 before importing pcbnew while the board exists,
    unless --overwrite-hand-edited-board is passed. post_route.sh documents
    that its finalize step is now refused.
    export_production.sh described the two accepted unconnected items as
    "pad-22" items. ENGINEERING.md documents them as IOVDD pads 22 and 10, and
    producti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
2026-10-28 firmware: show BADGE CONNECTED after a first badge contact made in standby
    The standby loop keeps answering the badge bus and calls
    tuner.unlock_badge_link(), but it discarded the "first contact" return.
    service_badge() turns that into the "badge" event (banner + scan_memes()
    so BADGE LINK joins the dial); standby did not. On wake the flag was set
    silently, the lineup was not rescanned, and every later contact returns
    False, so the banner never appeared at all.
    Now a first contact while parked sets pending = "badge" on wake, which the
    main loop dispatches through the existing badge handler.
    Verified in the sim with a scratch driver (CH- hold into standby, fake
    badge read while parked, CH+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
2026-11-04 docs: pins.md described badge I2C contact behavior the firmware lacks
    pins.md said the firmware reacts to any badge I2C contact with an antenna
    blip and a TV-static burst. code.py's service_badge() only reacts to the
    first-ever contact (BADGE LINK unlock, blip, BADGE CONNECTED banner);
    later descriptor reads return no event, and the static burst is the 0xF2
    command, as INTERFACING.md already says.
2026-11-09 firmware: guard the badge poll on dead-air and placeholder channels
    play_gif wraps its poll_badge()/service_badge() call so a badge bus error
    can never bubble into the top-level crash handler (print, 3s freeze,
    supervisor.reload). play_dead_air and play_missing made the same call
    unguarded. Those are the NO SIGNAL channels (including the CH 23 knock
    seat) and every TAPE NOT ON FILE placeholder. On those channels an
    OSError/MemoryError from the badge path rebooted the set.
    All three players now go through one guarded badge_tick() helper.
    Verified in the sim with a scratch driver (surf to CH 88 dead air, make
    i2ctarget.request raise OSError once, then send a real badge read).
    Before: the exc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
2026-11-09 docs/sim: fix stale tuner/MENU_SPEC notes and the selftest settings step
    - sim selftest: the settings step claimed to cycle AUTO SCAN ON then OFF
    "(leave defaults)". But row 0 has been BRIGHTNESS since the rows were
    reordered, so two presses left the run at HIGH (bright_idx 2 in
    nvm.bin). It now cycles brightness through all three values back to
    MED, and the settings block ends at defaults (verified from nvm.bin
    after a full 1700-frame run).
    - MENU_SPEC.md header still called the menu badge-poll gap "real"
    (with a stale line ref). poll_ui fixed it; the note says so now.
    - tuner.py header described a displayio/CircuitPython 9 renderer and
    the old CH+&CH- guide entry. tuner is lo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
